Kryptos-FR/NOMI-VR/resources/img/front.jpg

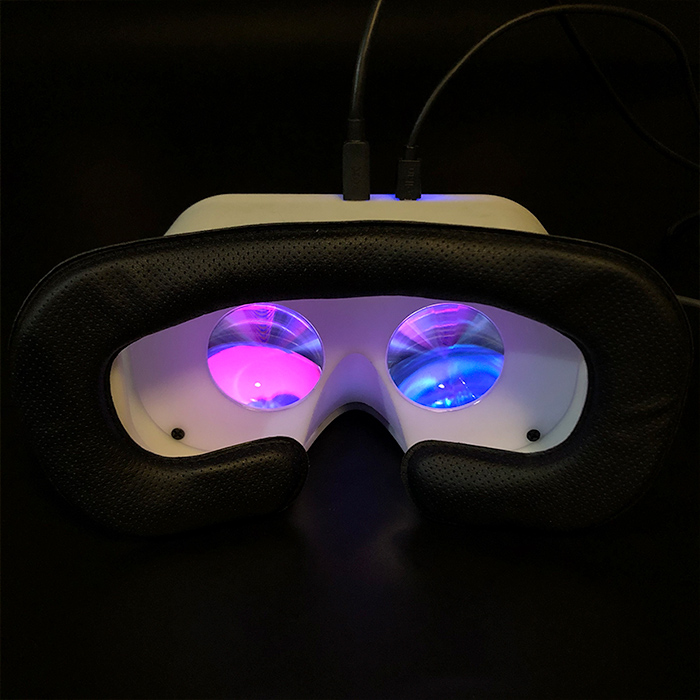
resources/img/front.jpg
