Kryptos-FR/NOMI-VR/resources/img/open.jpg

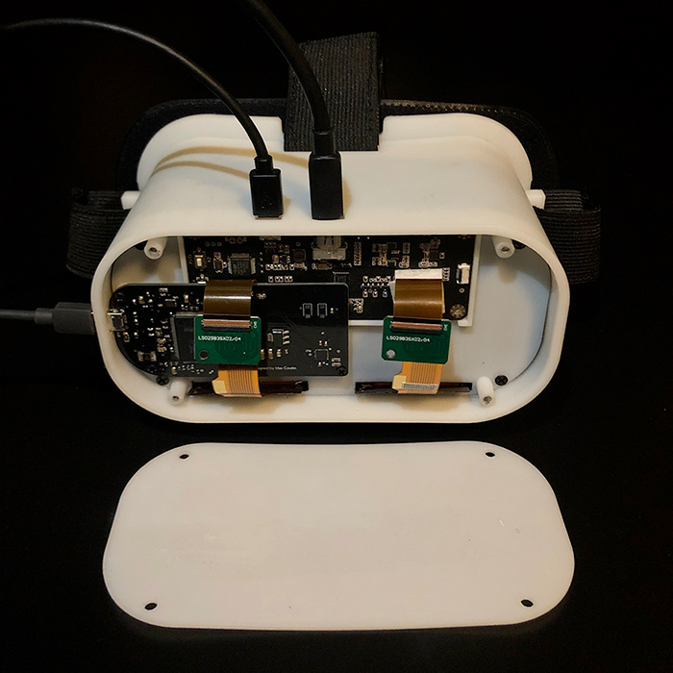
resources/img/open.jpg
