Kryptos-FR/NOMI-VR/resources/img/cards.jpg

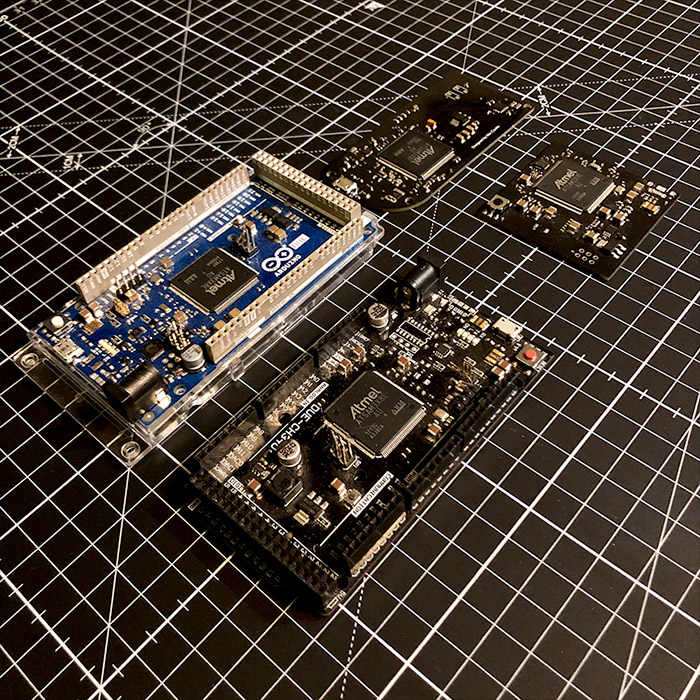
resources/img/cards.jpg
