Kryptos-FR/NOMI-VR/resources/img/display.jpg

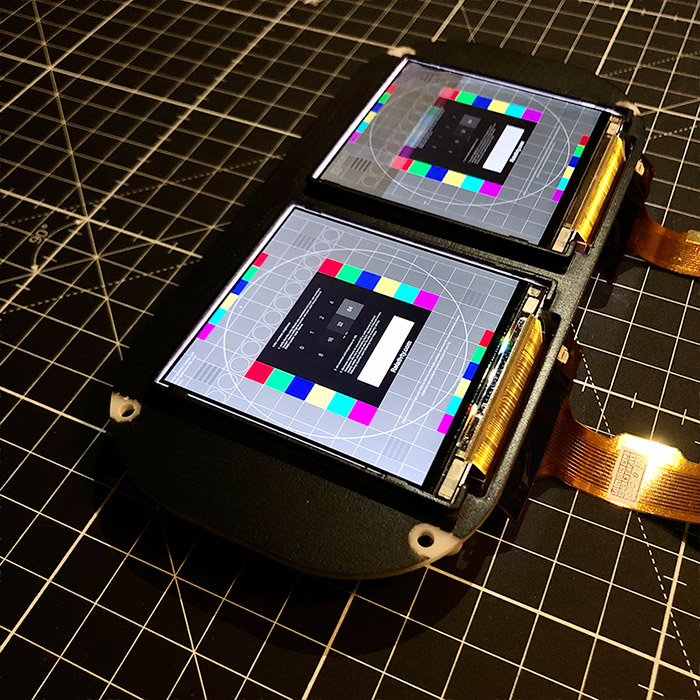
resources/img/display.jpg
