Kryptos-FR/NOMI-VR/resources/img/headset.jpg

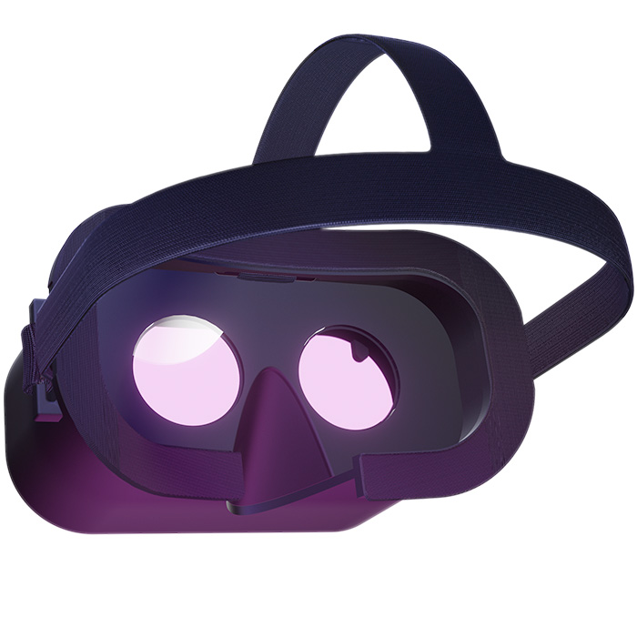
resources/img/headset.jpg
