Kryptos-FR/NOMI-VR/resources/img/headsetflipped.jpg

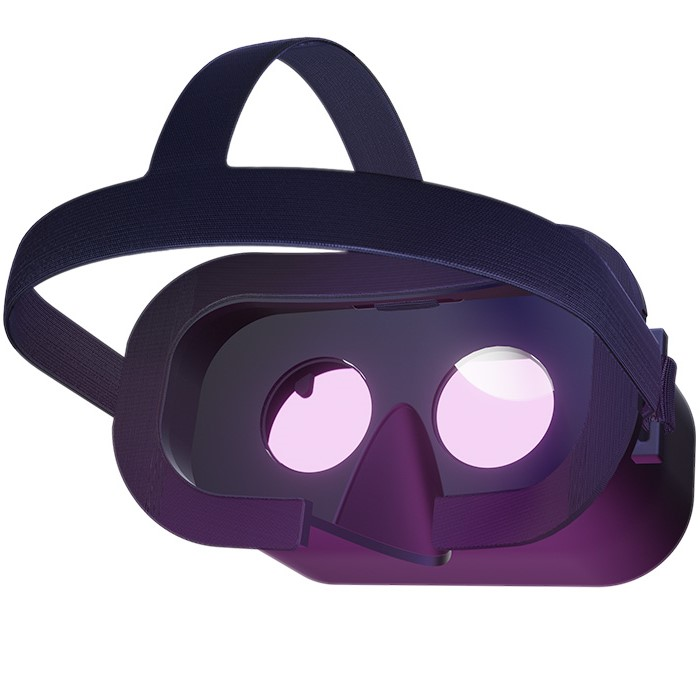
resources/img/headsetflipped.jpg
