Kryptos-FR/NOMI-VR/resources/img/motherboard.jpg

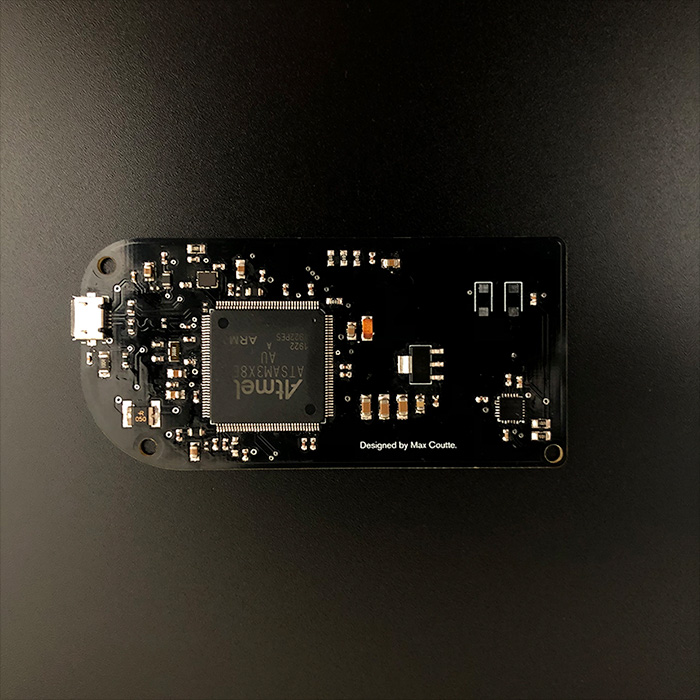
resources/img/motherboard.jpg
