Kryptos-FR/NOMI-VR/NOMI-VR_Headset/Build/nomivr_Electronics_build/Assembly/motherboard_BOM.xlsx

Item # | Ref Des | Qty | Manufacturer | Mfr. Part # | Value, Description | Package | Type | Link
1 | J1 | 1 | Molex | 473460001 | USB_MICRO-B_FEMALE-SMT | USB-B-MICRO-SMD | SMD | https://www.digikey.fr/product-detail/en/molex/0473460001/WM17141CT-ND/1782474
2 | C40, C42 | 2 | Yageo | CC0402KRX7R6BB104 | 0.1µF ±10% 10V Ceramic Capacitor X7R 0402 | 0402 | SMD | https://www.digikey.com/product-detail/en/yageo/CC0402KRX7R6BB104/311-1345-1-ND/2103129
3 | C1 | 1 | KEMET | C0805C474K3PAC7800 | 0.47µF ±10% 25V Ceramic Capacitor X5R 0805 | 0805 | SMD | https://www.digikey.com/product-detail/en/kemet/C0805C474K3PAC7800/399-15508-1-ND/7386906
4 | R4, R5, R6, R7 | 4 | Yageo | RC0603FR-07100KL | 100 kOhms ±1% 0.1W, 1/10W Chip Resistor 0603 | 0603 | SMD | https://www.digikey.com/product-detail/en/yageo/RC0603FR-07100KL/311-100KHRCT-ND/729836
5 | C18 | 1 | Murata Electronics | GRM033C71C104KE14D | 100nF 10% 16V Ceramic Capacitor X7S 0201 | 0201 | SMD | https://www.digikey.com/product-detail/en/murata-electronics/GRM033C71C104KE14D/490-10387-1-ND/5026260
6 | C6, C11, C12, C14, C15, C16, C20, C21, C22, C24, C25, C26, C27, C28, C29, C30, C36, C38, C39 | 19 | Yageo | CC0402KRX7R6BB104 | 100nF ±10% 10V Ceramic Capacitor X7R 0402 | 0402 | SMD | https://www.digikey.com/product-detail/en/yageo/CC0402KRX7R6BB104/311-1345-1-ND/2103129
7 | C7, C37, C44 | 3 | Yageo | CC0402KRX7R7BB103 | 10nF ±10% 16V Ceramic Capacitor X7R 0402 | 0402 | SMD | https://www.digikey.com/product-detail/en/yageo/CC0402KRX7R7BB103/311-1042-1-ND/302959
8 | L1, L2, L4 | 3 | TDK Corporation | MLZ2012N100LT000 | 10uH | 0805C | SMD | https://www.digikey.com/product-detail/en/tdk-corporation/MLZ2012N100LT000/445-6762-1-ND/2523583
9 | Y2 | 1 | Yangxing Tech | X322512MSB4SI | 12MHz ±10ppm 20pF 80Ω SMD-3225_4P SMD Crystal Resonators RoHS | CRYSTAL-SMD-3.2X2.5MM | SMD | https://lcsc.com/product-detail/SMD-Crystal-Resonators_Yangxing-Tech-X322512MSB4SI_C9002.html
10 | R13 | 1 | Yageo | RC1206JR-071ML | 1 MOhms ±5% 0.25W, 1/4W Chip Resistor 1206 (3216 Metric) Moisture Resistant Thick Film | 1206 | SMD | https://www.digikey.com/product-detail/en/yageo/RC1206JR-071ML/311-1.0MERCT-ND/732134
11 | R1, R2, R3 | 3 | Yageo | RC0402FR-071RL | 1 Ohms ±1% 0.063W, 1/16W Chip Resistor 0402 (1005 Metric) Moisture Resistant Thick Film | 0402 | SMD | https://www.digikey.com/product-detail/en/yageo/RC0402FR-071RL/311-1.00LRCT-ND/729461
12 | C41 | 1 | Yageo | CC0402KRX7R7BB222 | 2.2nF ±10% 16V Ceramic Capacitor X7R 0402 | 0402 | SMD | https://www.digikey.com/product-detail/en/yageo/CC0402KRX7R7BB222/311-1707-1-ND/5195609
13 | C8, C31, C32, C33, C34 | 5 | Yageo | CC0402JRNPO7BN220 | 22pF ±5% 16V Ceramic Capacitor C0G, NP0 0402 | 0402 | SMD | https://www.digikey.com/product-detail/en/yageo/CC0402JRNPO7BN220/311-3744-1-ND/8024833
14 | C2, C3, C4 | 3 | KEMET | C1206C226M9PACTU | 22µF ±20% 6.3V Ceramic Capacitor X5R 1206 | 1206 | SMD | https://www.digikey.com/product-detail/en/kemet/C1206C226M9PACTU/399-8183-1-ND/3471906
15 | Y1 | 1 | Seiko Epson | Q13FC1350000400 | 32.768KHz ±20ppm 12.5pF 70kΩ SMD-3215_2P SMD Crystal Resonators RoHS | CRYSTAL-SMD-3.2X1.5MM | SMD | https://lcsc.com/product-detail/SMD-Crystal-Resonators_Seiko-Epson_Q13FC1350000400_Seiko-Epson-Q13FC1350000400_C32346.html
16 | C5 | 1 | TDK Corporation | C3216X5R1A336M160AB | 33µF ±20% 10V Ceramic Capacitor X5R 1206 (3216 Metric) | 1206 | SMD | https://www.digikey.com/product-detail/en/tdk-corporation/C3216X5R1A336M160AB/445-6005-1-ND/2444046
17 | R8, R9 | 2 | Yageo | RC0402FR-0739RL | 39 Ohms ±1% 0.063W, 1/16W Chip Resistor 0402 | 0402 | SMD | https://www.digikey.com/product-detail/en/yageo/RC0402FR-0739RL/311-39.0LRCT-ND/729549
18 | R11, R12 | 2 | Yageo | RC0805JR-074K7L | 4.7 kOhms ±5% 0.125W, 1/8W Chip Resistor 0805 | 0805 | SMD | https://www.digikey.com/product-detail/en/yageo/RC0805JR-074K7L/311-4.7KARCT-ND/731274
19 | C43 | 1 | Yageo | CC0402KRX7R7BB472 | 4700pF ±10% 16V Ceramic Capacitor X7R 0402 (1005 Metric) | 0402 | SMD | https://www.digikey.com/product-detail/en/yageo/CC0402KRX7R7BB472/311-1709-1-ND/5195611
20 | C9, C10, C13, C17, C19, C23, C35 | 7 | Yageo | CC0805KRX5R5BB475 | 4.7µF ±10% 6.3V Ceramic Capacitor X5R 0805 | 0805 | SMD | https://www.digikey.com/product-detail/en/yageo/CC0805KRX5R5BB475/311-3422-1-ND/7164443
21 | R10 | 1 | Yageo | RT0805BRD076K8L | 6.8 kOhms ±0.1% 0.125W, 1/8W Chip Resistor 0805 (2012 Metric) Thin Film | 0805 | SMD | https://www.digikey.com/product-detail/en/yageo/RT0805BRD076K8L/YAG1966CT-ND/5139414
22 | U1 | 1 | Microchip Technology | ATSAM3X8EA-AU | ATSAM3X8EA-AU, AT91SAM ARM-based Flash MCU ATSAM3X8EA-AU | LQFP144 | SMD | https://www.digikey.fr/product-detail/en/microchip-technology/ATSAM3X8EA-AU/ATSAM3X8EA-AU-ND/3128687
23 | RV1, RV2, RV3 | 3 | Bourns Inc. | CG0603MLC-05E | CG0603MLC-05E, Varistor, ESD Protector, 5VDC,20V,0603 Bourns MLC Series Power Varistor 0.5pF 20V 0603 Case | 0603 | SMD | https://www.digikey.fr/product-detail/en/bourns-inc/CG0603MLC-05E/CG0603MLC-05ECT-ND/3438061
24 | U2 | 1 | Texas Instruments | LM3940IMPX-3.3/NOPB | LM3940IMPX-3.3/NOPB, Low Dropout Regulator | SOT-223-4 | SMD | https://www.digikey.com/product-detail/en/texas-instruments/LM3940IMPX-3.3-NOPB/LM3940IMPX-3.3-NOPBCT-ND/3526977
25 | F1 | 1 | Bourns Inc. | MF-SMDF050-2 | MF-SMDF050, MF-SMDF Series - PRC Resettable Fuses | MF-SMDF050 | SMD | https://www.digikey.com/product-detail/en/bourns-inc/MF-SMDF050-2/MF-SMDF050-2CT-ND/662854
26 | L3 | 1 | Würth Elektronik | 74279206 | FERRITE BEAD 30 OHM 0805 1LN | 0805 | SMD | https://www.digikey.com/product-detail/en/w-rth-elektronik/74279206/732-1611-1-ND/1639555
27 | U3 | 1 | TDK InvenSense | MPU-6050 | MPU-6050, Invensense MPU-6050 6-Axis Gryoscope/Accelerometer | 24-QFN (4x4) | SMD | https://www.digikey.com/product-detail/en/tdk-invensense/MPU-6050/1428-1007-1-ND/4038010
28 | ERASE, RESET | 2 | ALPS Electric | SKRKAEE020 | SKRKAEE020 | SOD4829X200 | SMD
