Kryptos-FR/NOMI-VR/NOMI-VR_Headset/Build/nomivr_Mechanical_build/screws_BOM.xlsx

Thread # | Qty | Thickness | Length | Description | Manufacturer | Link
1 | 4 | M1.6 | 3 | Phillips | YINSONG | https://www.amazon.fr/YINSONG-M1-6-M1-7-Vis-M%C3%A9taux/dp/B07PVNMQYZ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
2 | 4 | M3 | 4 | Phillips | XFentech | https://www.amazon.fr/XFentech-Vis-m%C3%A9taux-Cruciforme-%C3%A9lectroniques/dp/B07PRWBBSZ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
3 | 4 | M3 | 6 | Phillips | YINSONG | https://www.amazon.fr/YINSONG-Vis-M%C3%A9caniques-M3-%C3%A9lectroniques/dp/B07PVNLTH3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
4 | 4 | M3 | 6 | Phillips | YINSONG | https://www.amazon.fr/YINSONG-Vis-M%C3%A9caniques-M3-%C3%A9lectroniques/dp/B07PVNLTH3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
5 | 4 | M4 | 8.5 | Thumb Screw | sourcingmap | https://www.amazon.fr/Sourcingmap%C2%AE-plaqu%C3%A9-Renforcent-molet%C3%A9-Boulons/dp/B01HSTUO1K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
6 | 4 | M3 | 4 | Phillips | XFentech | https://www.amazon.fr/XFentech-Vis-m%C3%A9taux-Cruciforme-%C3%A9lectroniques/dp/B07PRWBBSZ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
