Kryptos-FR/NOMI-VR/NOMI-VR_Headset/Build/nomivr_Mechanical_build/eyes_panel.stl

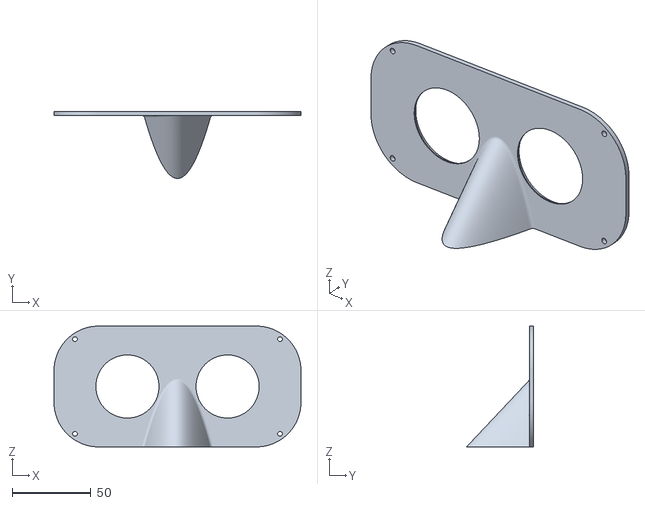
[picture p8: CAD file, 2021-04-18]
NOMI-VR_Headset/Build/nomivr_Mechanical_build/eyes_panel.stl
156.6 x 42.5 x 76.6
