Kryptos-FR/NOMI-VR/NOMI-VR_Headset/Build/Relativty_Driver/nomivr/resources/rendermodels/generic_hmd/generic_hmd.obj

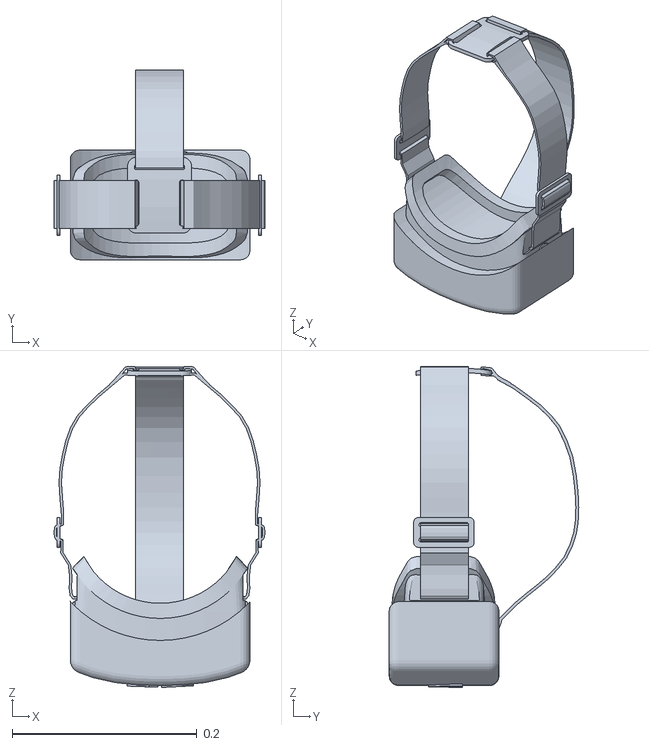
[picture p9: CAD file, 2021-04-18]
NOMI-VR_Headset/Build/Relativty_Driver/nomivr/resources/rendermodels/generic_hmd/generic_hmd.obj
0.228 x 0.205 x 0.348
