Kryptos-FR/NOMI-VR/NOMI-VR_Headset/Build/nomivr_Mechanical_build/foam_support.stl

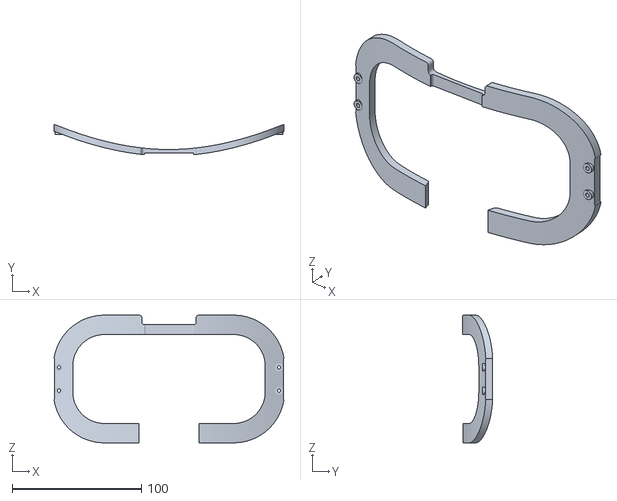
[picture p10: CAD file, 2021-04-18]
NOMI-VR_Headset/Build/nomivr_Mechanical_build/foam_support.stl
177.7 x 23.5 x 98.6
