Kryptos-FR/NOMI-VR/NOMI-VR_Headset/Build/nomivr_Mechanical_build/screen_panel.stl

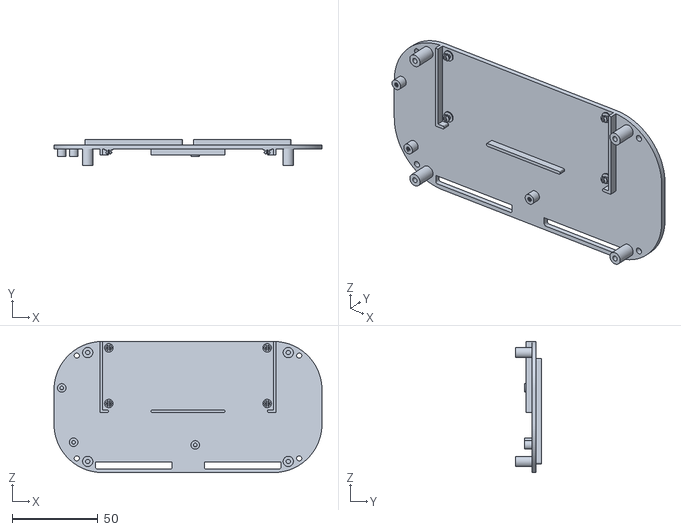
[picture p11: CAD file, 2021-04-18]
NOMI-VR_Headset/Build/nomivr_Mechanical_build/screen_panel.stl
156.6 x 15.5 x 76.6
