Kryptos-FR/NOMI-VR/NOMI-VR_Headset/Build/nomivr_Mechanical_build/body.stl

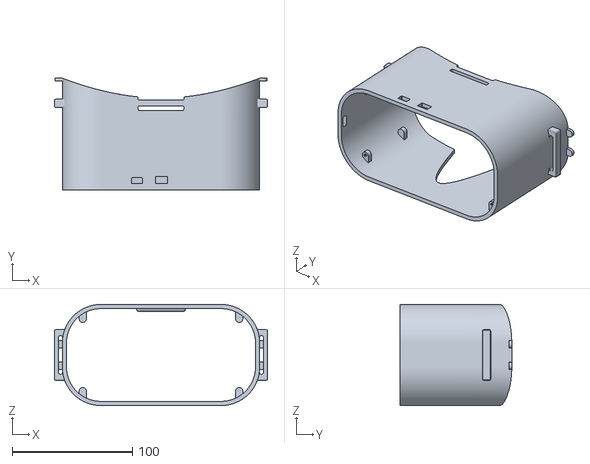
[picture p12: CAD file, 2021-04-18]
NOMI-VR_Headset/Build/nomivr_Mechanical_build/body.stl
177.0 x 92.7 x 84.0
