Kryptos-FR/NOMI-VR/NOMI-VR_Headset/Build/nomivr_Mechanical_build/front_panel.stl

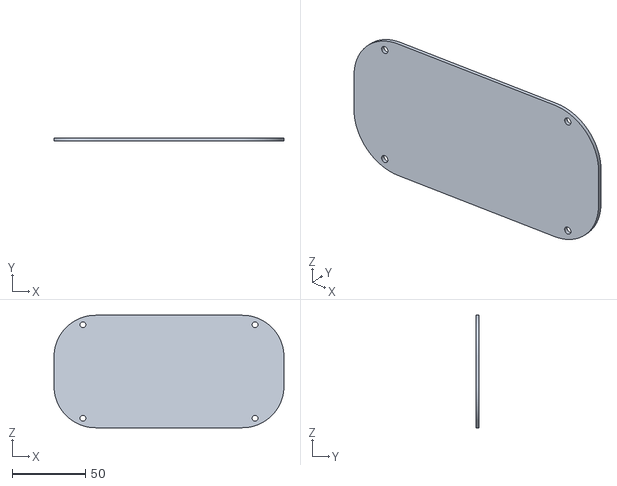
[picture p13: CAD file, 2021-04-18]
NOMI-VR_Headset/Build/nomivr_Mechanical_build/front_panel.stl
156.6 x 2.00 x 76.6
