Kryptos-FR/NOMI-VR/(list of files, cad)

Other CAD files:
NOMI-VR_Headset/Source/nomivr_Mechanical_source/mechanic.f3d
