Kryptos-FR/NOMI-VR/NOMI-VR_Headset/Source/nomivr_Electronics_source/motherboard.brd

## EAGLE design NOMI-VR_Headset/Source/nomivr_Electronics_source/motherboard.brd (2021-04-16)

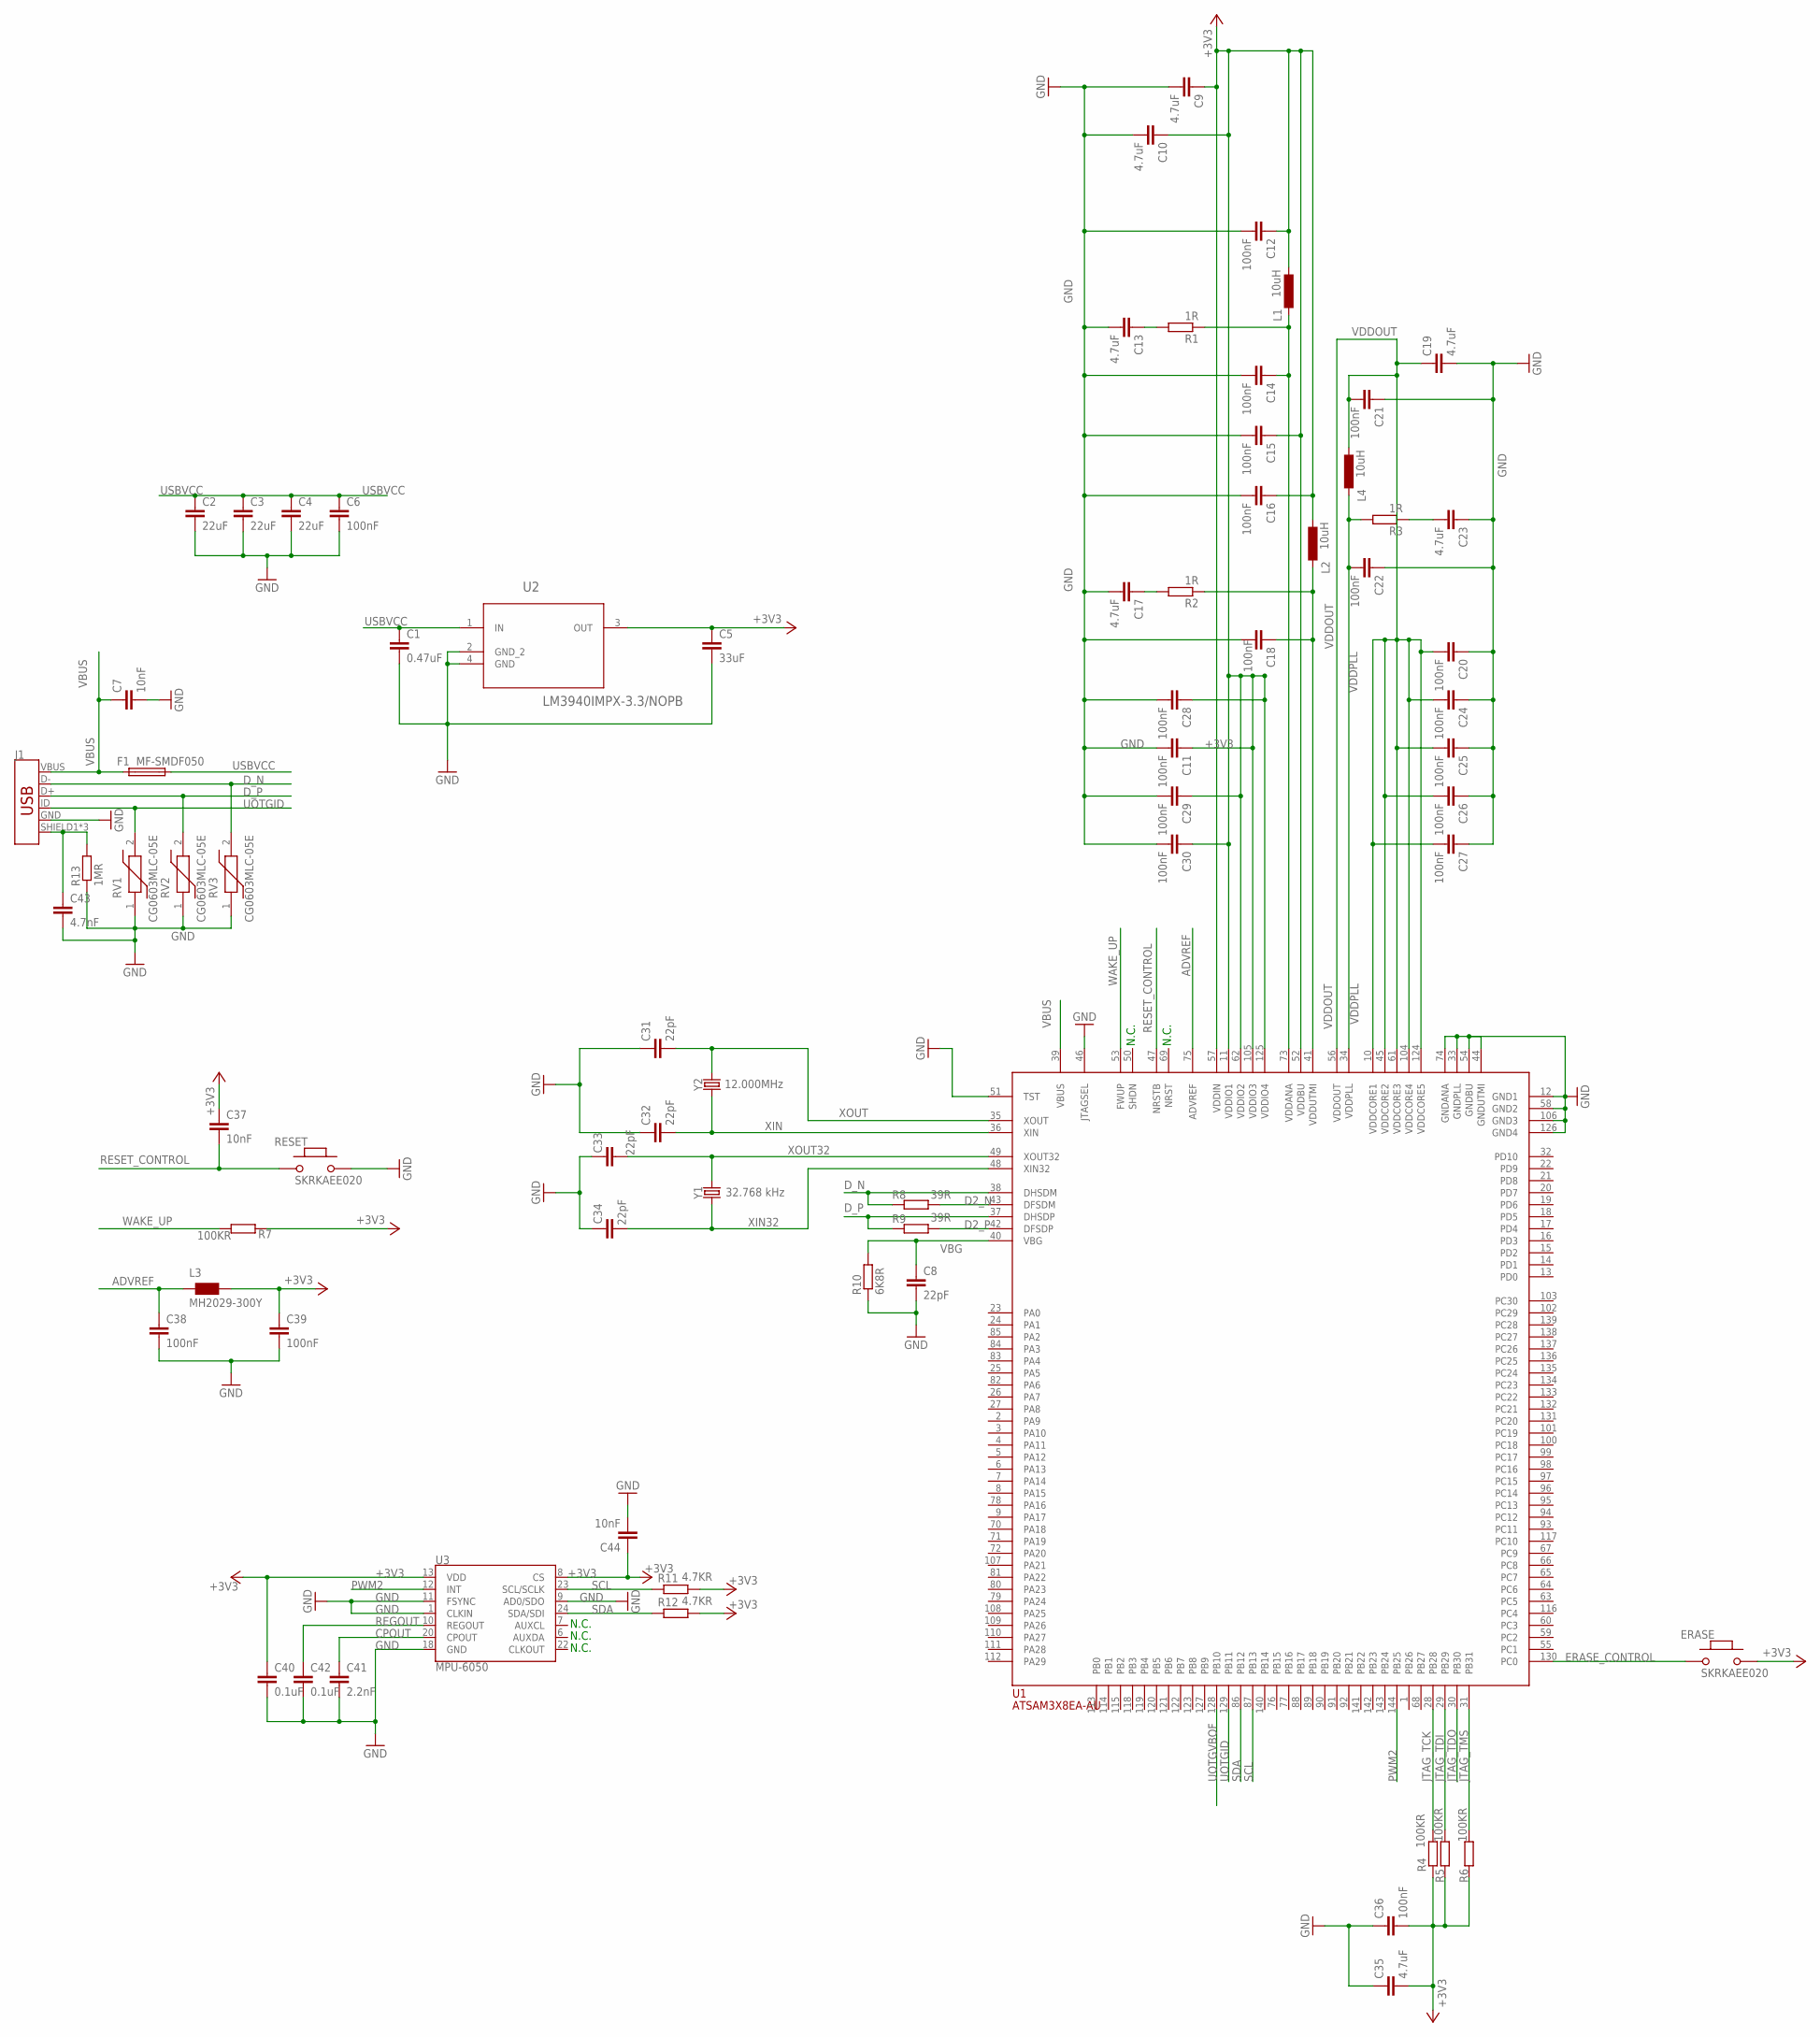
[picture p14: schematic motherboard.sch]

Parts:
C1: 0.47uF; C0805
C2, C3, C4: 22uF; C1206
C5: 33uF; C1206
C6, C11, C12, C14, C15, C16, C20, C21, C22, C24, C25, C26, C27, C28, C29, C30, C36, C38, C39: 100nF; C0402
C7, C37, C44: 10nF; C0402
C8, C31, C32, C33, C34: 22pF; C0402
C9, C10, C13, C17, C19, C23, C35: 4.7uF; C0805
C18: 100nF; C0201
C40, C42: 0.1uF; C0402
C41: 2.2nF; C0402
C43: 4.7nF; C0402
ERASE: SKRKAEE020; SOD4829X200
F1: MF-SMDF050
J1: USB_MICRO-B_FEMALE-SMT; USB-B-MICRO-SMD
L1, L2, L4: 10uH; L2012C
L3: MH2029-300Y; 2012-EU
R1, R2, R3: 1R; R0402
R4, R5, R6, R7: 100KR; R0603
R8, R9: 39R; R0402
R10: 6K8R; R2012
R11, R12: 4.7KR; R0805
R13: 1MR; R1206
RESET: SKRKAEE020; SOD4829X200
RV1, RV2, RV3: CG0603MLC-05E; VARC1608X55N
U1: ATSAM3X8EA-AU; LQFP144
U2: LM3940IMPX-3.3/NOPB; SOT230P696X180-4N
U3: MPU-6050; QFN-24-EP
Y1: 32.768 kHz; CRYSTAL-SMD-3.2X1.5MM
Y2: 12.000MHz; CRYSTAL-SMD-3.2X2.5MM

Connections:
+3V3: C5.1, C9.1, C10.1, C11.1, C12.1, C15.1, C16.1, C28.1, C29.1, C30.1, C35.2, C36.2, C37.1, C39.1, C40.1, C44.1, ERASE.2, L1.1, L2.1, L3.2, R4.1, R5.1, R6.1, R7.1, R11.2, R12.2, U1.11 (VDDIO1), U1.52 (VDDBU), U1.57 (VDDIN), U1.62 (VDDIO2), U1.105 (VDDIO3), U1.125 (VDDIO4), U2.3 (OUT), U3.8 (CS), U3.13 (VDD)
ADVREF: C38.1, L3.1, U1.75 (ADVREF)
CPOUT: C41.1, U3.20 (CPOUT)
D2_N: R8.2, U1.43 (DFSDM)
D2_P: R9.2, U1.42 (DFSDP)
D_N: J1.D-, R8.1, RV3.2, U1.38 (DHSDM)
D_P: J1.D+, R9.1, RV2.2, U1.37 (DHSDP)
ERASE_CONTROL: ERASE.1, U1.130 (PC0)
GND: C1.2, C2.2, C3.2, C4.2, C5.2, C6.2, C7.2, C8.2, C9.2, C10.2, C11.2, C12.2, C13.2, C14.2, C15.2, C16.2, C17.2, C18.2, C19.2, C20.1, C21.1, C22.1, C23.1, C24.1, C25.1, C26.1, C27.1, C28.2, C29.2, C30.2, C31.1, C32.1, C33.1, C34.1, C35.1, C36.1, C38.2, C39.2, C40.2, C41.2, C42.2, C43.2, C44.2, J1.GND, R10.1, R13.1, RESET.2, RV1.1, RV2.1, RV3.1, U1.12 (GND1), U1.33 (GNDPLL), U1.44 (GNDUTMI), U1.46 (JTAGSEL), U1.51 (TST), U1.54 (GNDBU), U1.58 (GND2), U1.74 (GNDANA), U1.106 (GND3), U1.126 (GND4), U2.2 (GND_2), U2.4 (GND), U3.1 (CLKIN), U3.9 (AD0/SDO), U3.11 (FSYNC), U3.18 (GND)
JTAG_TCK: R4.2, U1.28 (PB28)
JTAG_TDI: R5.2, U1.29 (PB29)
JTAG_TDO: U1.30 (PB30)
JTAG_TMS: R6.2, U1.31 (PB31)
unnamed: C43.1, J1.SHIELD1 (SHIELD), J1.SHIELD2 (SHIELD), J1.SHIELD3 (SHIELD), R13.2
unnamed: C13.1, R1.2
unnamed: C17.1, R2.2
unnamed: C23.2, R3.1
unnamed: C14.1, L1.2, R1.1, U1.73 (VDDANA)
unnamed: C18.1, L2.2, R2.1, U1.41 (VDDUTMI)
PWM2: U1.144 (PB25), U3.12 (INT)
REGOUT: C42.1, U3.10 (REGOUT)
RESET_CONTROL: C37.2, RESET.1, U1.47 (NRSTB)
SCL: R11.1, U1.87 (PB13), U3.23 (SCL/SCLK)
SDA: R12.1, U1.86 (PB12), U3.24 (SDA/SDI)
UOTGID: J1.ID, RV1.2, U1.129 (PB11)
UOTGVBOF: U1.128 (PB10)
USBVCC: C1.1, C2.1, C3.1, C4.1, C6.1, F1.2, U2.1 (IN)
VBG: C8.1, R10.2, U1.40 (VBG)
VBUS: C7.1, F1.1, J1.VBUS, U1.39 (VBUS)
VDDOUT: C19.1, C20.2, C21.2, C24.2, C25.2, C26.2, C27.2, L4.1, U1.10 (VDDCORE1), U1.45 (VDDCORE2), U1.56 (VDDOUT), U1.61 (VDDCORE3), U1.104 (VDDCORE4), U1.124 (VDDCORE5)
VDDPLL: C22.2, L4.2, R3.2, U1.34 (VDDPLL)
WAKE_UP: R7.2, U1.53 (FWUP)
XIN: C32.2, U1.36 (XIN), Y2.1
XIN32: C34.2, U1.48 (XIN32), Y1.P$1 (1)
XOUT: C31.2, U1.35 (XOUT), Y2.3 (2)
XOUT32: C33.2, U1.49 (XOUT32), Y1.P$2 (2)

Notes on the sheet:
N.C.

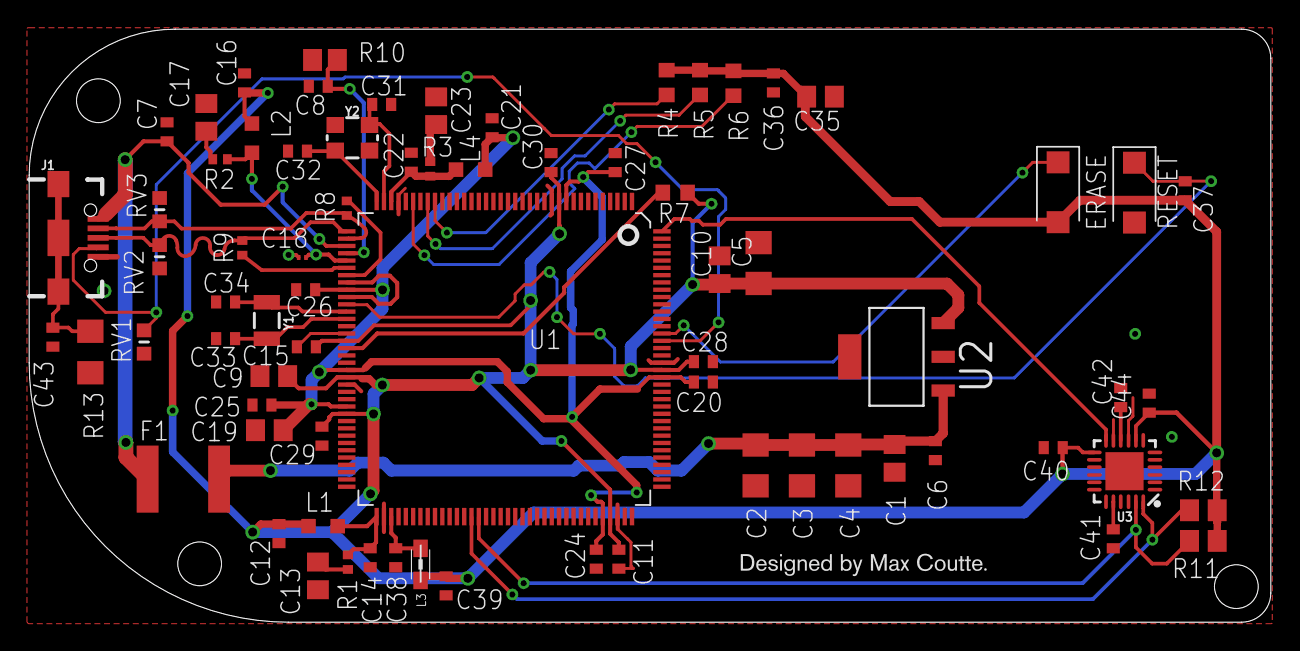
[picture p15: board motherboard.brd from above]

Board: 2 copper layers, 85.1 x 40.6 mm, 73 parts (0 on the bottom side), 34 nets.
