Kryptos-FR/NOMI-VR/NOMI-VR_Headset/Build/README.md

# * **These Are All The Files Needed To Build The NOMI VR Headset** *
### Build | Is all the files needed to build / make the NOMI VR Headset
