Kryptos-FR/NOMI-VR/(commit log)

2021-04-16 Added Source Electronics
    [motherboard.brd, motherboard.sch]
2021-04-17 Added Mechanical Source
    [mechanic.f3d]
2021-04-17 File System Restructured For Easier Use
    [mechanic.f3d, motherboard.brd, motherboard.sch]
2021-04-17 Updated files for public release
    [mechanic.f3d, motherboard.brd, motherboard.sch]
2021-04-17 added .gitignore
    [mechanic.f3d, motherboard.brd, motherboard.sch]
2021-04-18 Added Mechanical & Electronic Build Files
    [body.stl, eyes_panel.stl, foam_support.stl, front_panel.stl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]
2021-04-18 Added Driver Files
    [generic_hmd.obj]
